SharKingStudios/Bubbles/README.md

# Bubbles
My first combat robot, built as a modified version of a pbk.

## Renders

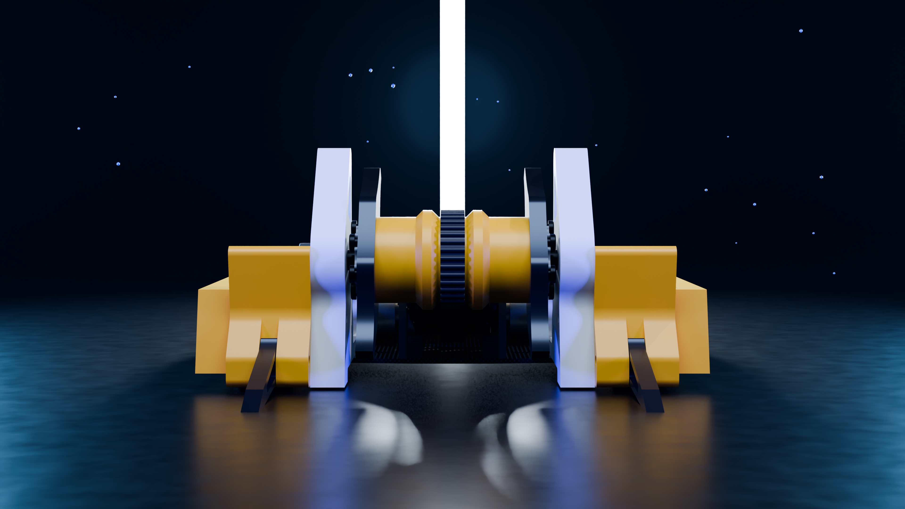
[picture p1: Renders/Bubbles Front.png]
Front render

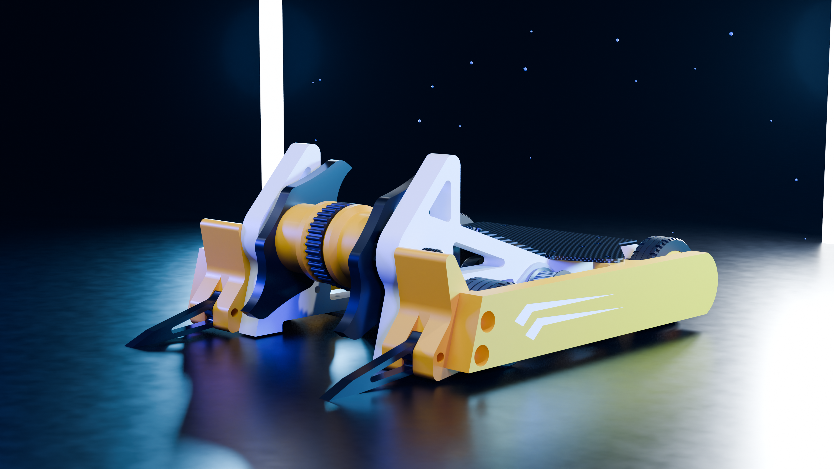
[picture p2: Renders/Bubbles 3_4.png]
Three-quarter render

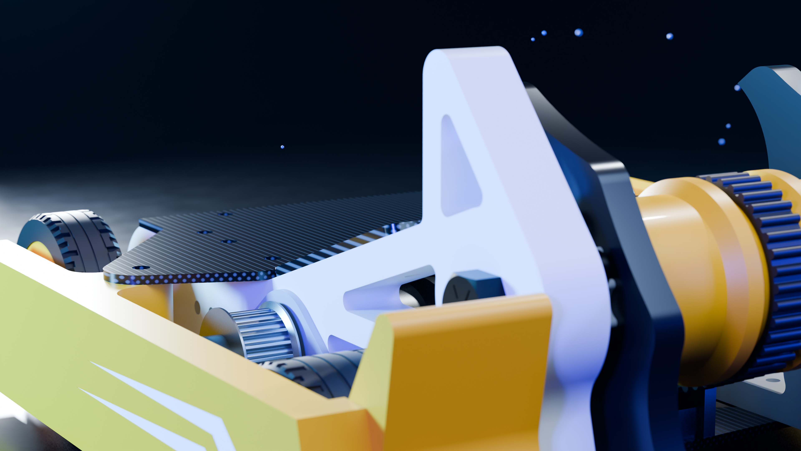
[picture p3: Renders/Bubbles Detail.png]
Detail render
