SharKingStudios/Bubbles/Renders/Bubbles Far.png

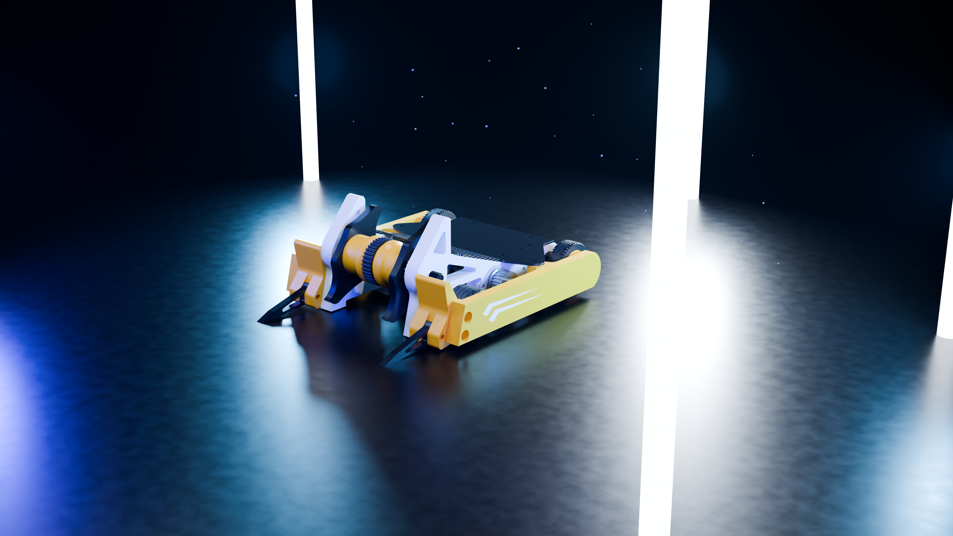
Renders/Bubbles Far.png
