SharKingStudios/Bubbles/Renders/poster_front_transparent.png

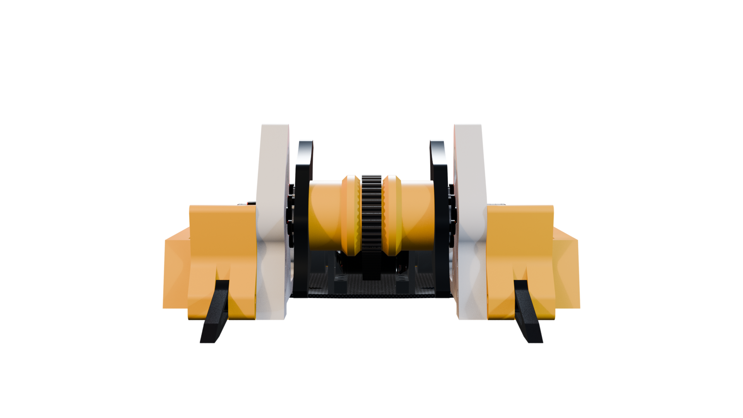
Renders/poster_front_transparent.png
