SharKingStudios/Bubbles/Renders/poster_threequarter_transparent.png

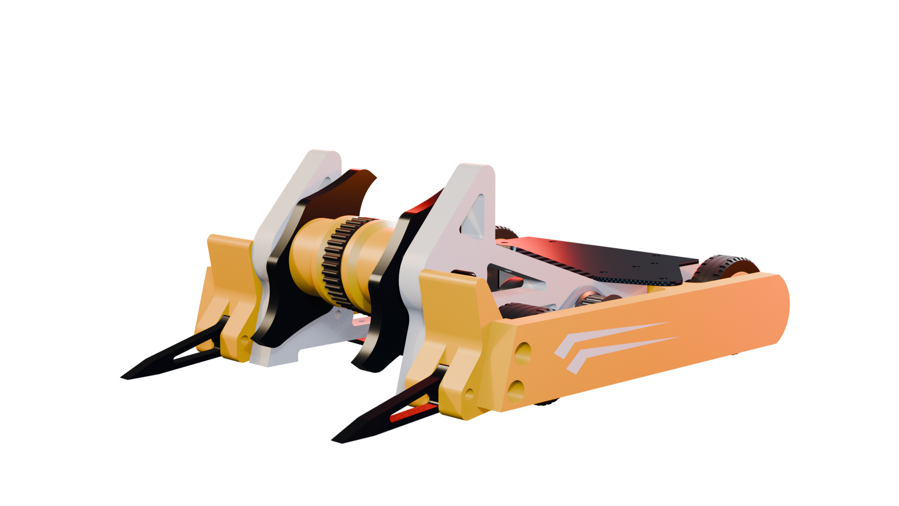
Renders/poster_threequarter_transparent.png
