SharKingStudios/Bubbles/CAD/Bubbles V1 Assembly.step

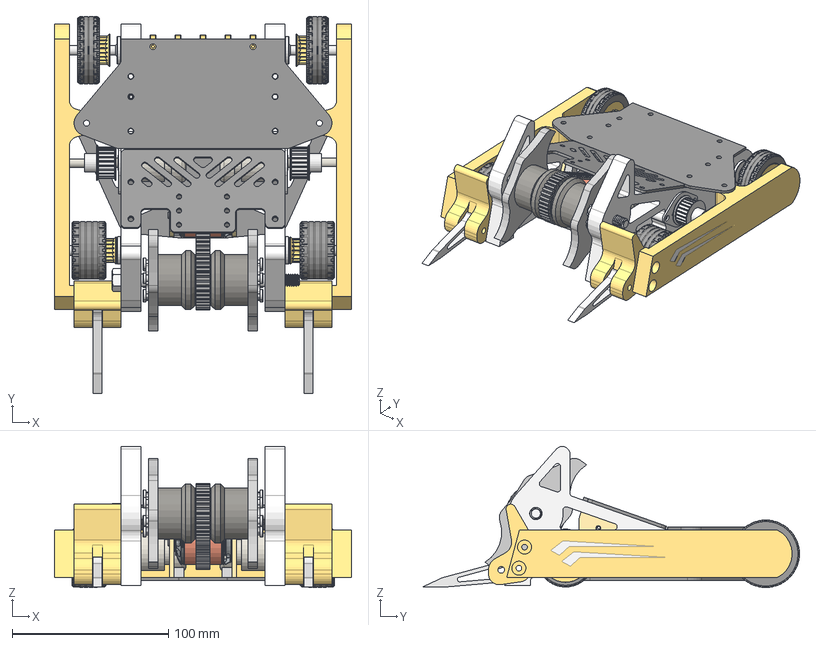
[picture p7: CAD file, 2026-10-04]
CAD/Bubbles V1 Assembly.step
190.0 x 241.1 x 90.2 mm
Left Wedge Connector
Left UHMW
RepeatMax__Cut-Extrude2 x 2
Right UHMW
Rear Armor TPU
Bottom Plate CF
Mini_nutstrip_3__LPattern2 x 4
Right Wedge Connector
195-3M-09__CrvPattern1
RR-401__Revolve2 x 4
Right Armor TPU x 2
LEGO Tire 43.2x14_Kit__Stock-WheelAssembly_43.2x14_v11.step-1 x 2
113-PBK-Mk2__Chamfer2 x 2
111-PBK-Mk2__<17T 3M>-<PatternGearBelt01> x 2
LEGO Tire 37x22_Kit__CirPattern3 x 2
Left Motor Upright
Top Plate CF
Motor Cover CF
22T 3M Pulley x 2
020-PBK-Mk1__Boss-Extrude1 x 2
0318-18x4.5_HEX-HEAD_91257A600__Boss-Extrude5
Right Motor Upright
Short Fork x 2
evo2836_asm.stp__Fillet1
evo2836_asm.stp__evo2836_asm.stp<1>[5]
evo2836_asm.stp__evo2836_asm.stp<1>[4]
evo2836_asm.stp__evo2836_asm.stp<1>[6]
evo2836_asm.stp__evo2836_asm.stp<1>[1]
switch half R1.1.IGS__Mini_Power_Switch.IGS x 34
copper tab.IGS__Mini_Power_Switch.IGS
SHCS 4-40x375_HX-SHCS 0.112-40x0.375x0.375-S.IGS__Mini_Power_Switch.I GS
copper tab_through hole.IGS__Mini_Power_Switch.IGS
FR104ZZ_57155K555__CirPattern3[1]
FR104ZZ_57155K555__Cut-Revolve1[1]
FR104ZZ_57155K555__CirPattern3[8]
FR104ZZ_57155K555__Revolve3
FR104ZZ_57155K555__CirPattern3[5]
FR104ZZ_57155K555__CirPattern3[4]
FR104ZZ_57155K555__Revolve4[2]
FR104ZZ_57155K555__CirPattern3[2]
FR104ZZ_57155K555__CirPattern3[7]
FR104ZZ_57155K555__CirPattern3[6]
FR104ZZ_57155K555__CirPattern3[3]
FR104ZZ_57155K555__Revolve4[1]
FR104ZZ_57155K555__Cut-Revolve1[2]
FR104ZZ_57155K555__CirPattern3[9]
8-32x0250x2250_HEX_STANDOFF_91780A043__Fillet1 x 6
8-32x.625_SOCKET-HEAD_LOW-PROFILE_92220A154__Cut-Extrude2 x 12
201-PBK-Mk1__Chamfer1 x 2
210-PBK-Mk1__CirPattern1 x 2
0312x0500x0563 SCE59 NEEDLE BEARING_5905K495__CirPattern1[2] x 2
0312x0500x0563 SCE59 NEEDLE BEARING_5905K495__CirPattern1[7] x 2
0312x0500x0563 SCE59 NEEDLE BEARING_5905K495__CirPattern1[13] x 2
0312x0500x0563 SCE59 NEEDLE BEARING_5905K495__Revolve3 x 2
0312x0500x0563 SCE59 NEEDLE BEARING_5905K495__CirPattern1[14] x 2
0312x0500x0563 SCE59 NEEDLE BEARING_5905K495__CirPattern1[12] x 2
0312x0500x0563 SCE59 NEEDLE BEARING_5905K495__CirPattern1[4] x 2
0312x0500x0563 SCE59 NEEDLE BEARING_5905K495__CirPattern1[11] x 2
0312x0500x0563 SCE59 NEEDLE BEARING_5905K495__CirPattern1[10] x 2
0312x0500x0563 SCE59 NEEDLE BEARING_5905K495__Revolve2 x 2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
