SharKingStudios/Bubbles/(list of files, cad)

Other CAD files:
Renders/Bubbles.blend
Renders/Bubbles_cinematic.blend
